crustee21/AI-Assisted-Ankle-Exoskeleton/Hardware/3D Models/Footplate.stl

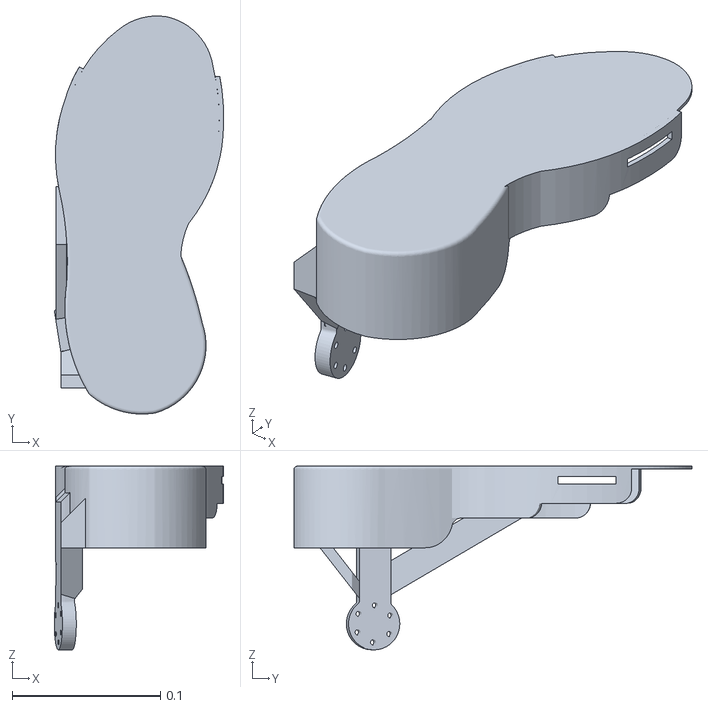
[picture p1: CAD file, 2026-11-01]
Hardware/3D Models/Footplate.stl
0.114 x 0.268 x 0.124
