crustee21/AI-Assisted-Ankle-Exoskeleton/Hardware/3D Models/Strut.stl

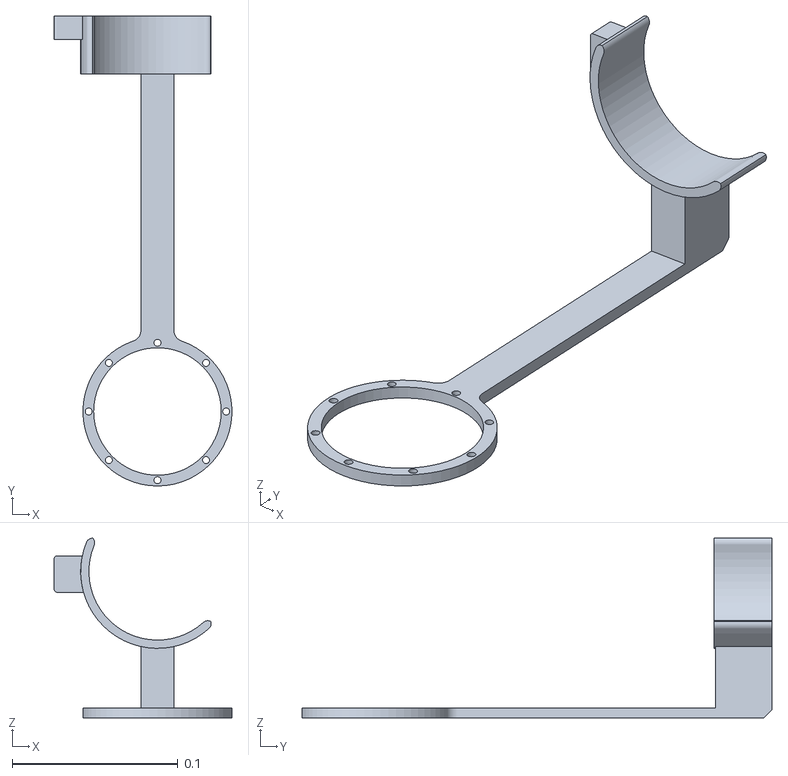
[picture p2: CAD file, 2026-11-01]
Hardware/3D Models/Strut.stl
0.107 x 0.284 x 0.109
