crustee21/AI-Assisted-Ankle-Exoskeleton/Hardware/3D Models/Old Prototypes/StrutV1.stl

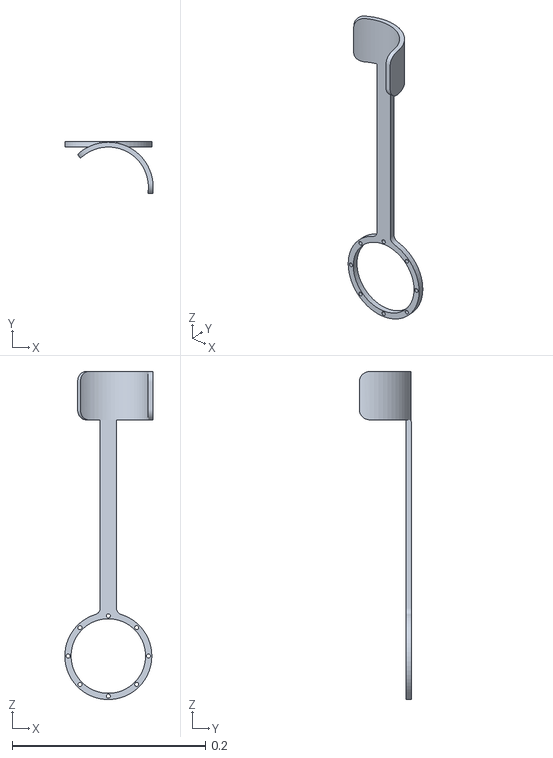
[picture p3: CAD file, 2026-11-01, an earlier design]
Hardware/3D Models/Old Prototypes/StrutV1.stl
0.0914 x 0.0543 x 0.339
