crustee21/AI-Assisted-Ankle-Exoskeleton/(commit log)

2026-11-01 Enhance README with project details and motivation
    Expanded the README to include motivation, functionality, current status, hardware details, and future improvements for the ankle exoskeleton project.
2026-11-01 Added 3D Model files
    [Footplate.stl, Strut.stl, StrutV1.stl]
2026-11-01 add conv2
    [hls_config.cfg]
